zUrp-Astronomics/Cam87-Redux/#1_Logic_board/Cam87_Redux - Logic_board_v1.1 - 2_2D-view_bot.png

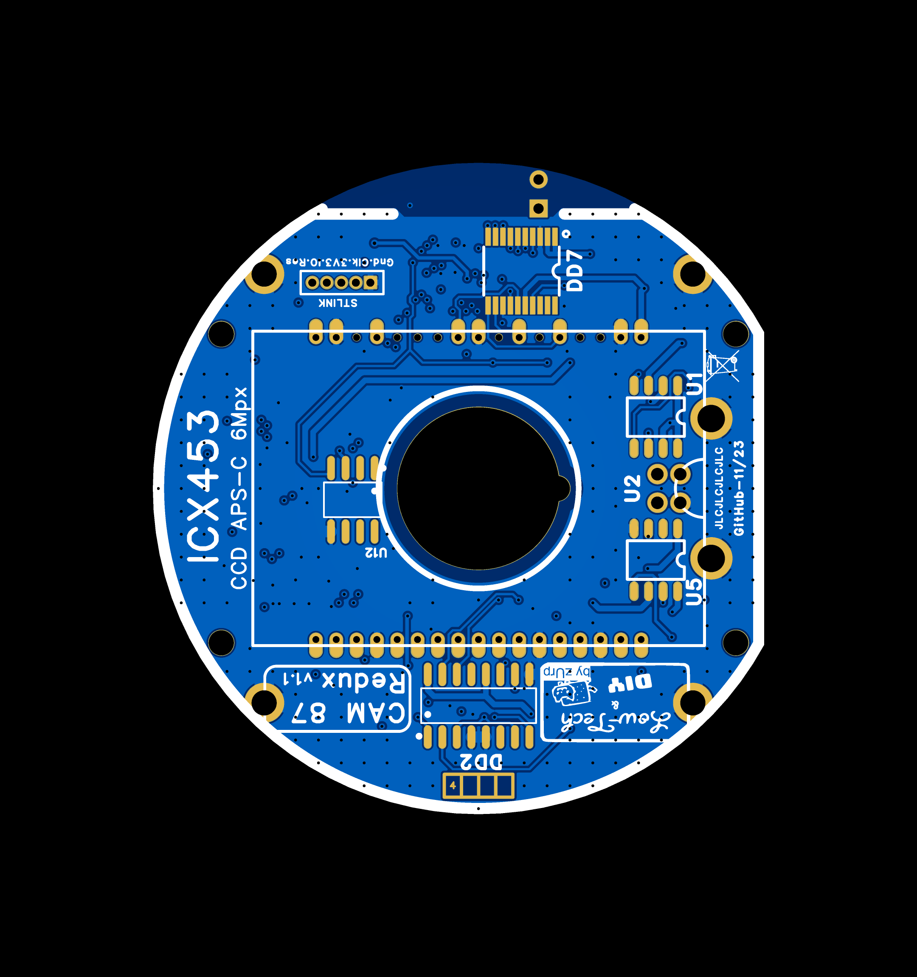
#1_Logic_board/Cam87_Redux - Logic_board_v1.1 - 2_2D-view_bot.png
