zUrp-Astronomics/Cam87-Redux/#2_Power_board/Cam87_Redux- Power_board_v1.1 - 2_2D-view_bot.png

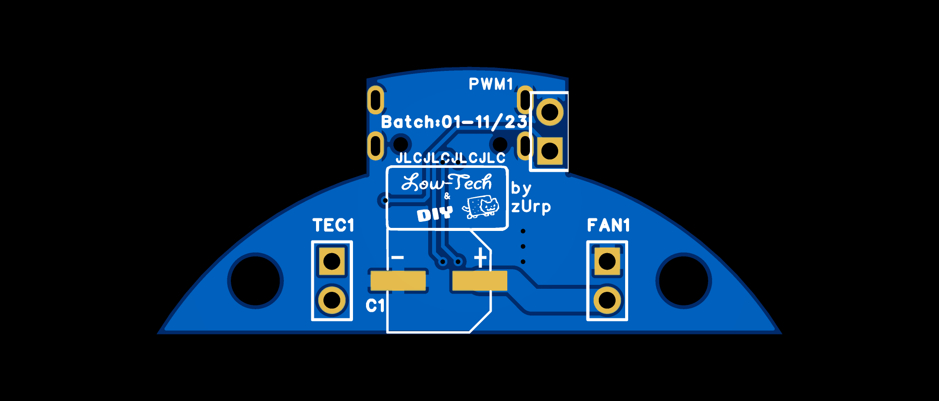
#2_Power_board/Cam87_Redux- Power_board_v1.1 - 2_2D-view_bot.png
