zUrp-Astronomics/Cam87-Redux/#2_Power_board/Cam87_Redux- Power_board_v1.1 - 4_BOM.xlsx

No. | Quantity | Device | Designator | Footprint | Value | Manufacturer Part | Manufacturer | Supplier Part | Supplier | Add into BOM | Name | Primary Category | Secondary Category | JLCPCB Stock | JLCPCB Price | JLCPCB Part Class
1 | 1 | 0603WAF0000T5E | 12V | R0603 | 0Ω | 0603WAF0000T5E | UNI-ROYAL(厚声) | C21189 | LCSC | yes | 0Ω | Resistors | Chip Resistor - Surface Mount | 9418308 | 0.00645 | Basic Part
2 | 1 | OVZ560M1ETR-0606 | C1 | CAP-SMD_BD6.3-L6.6-W6.6-FD-A | 56uF | OVZ560M1ETR-0606 | lelon(立隆) | C250116 | LCSC | yes | 56uF |  |  | 635 | 1.237 | ExtendedPart
3 | 1 | CL05A105KA5NQNC | C2 | C0402 | 1uF | CL05A105KA5NQNC | SAMSUNG(三星) | C52923 | LCSC | yes | 1uF |  |  | 2774039 | 0.0237 | BasicPart
4 | 3 | JST-XH-2P-M | FAN1,PWM1,TEC1 | HDR-M-2.54_1X2 |  | JST-XH-2P-M | JST | JST-XH-2P-M |  | yes | JST-XH-2P |  |  | 0
5 | 1 | AO3401A_C15127 | Q1 | SOT-23_L2.9-W1.3-P1.90-LS2.4-BR |  | AO3401A | AOS | C15127 | LCSC | yes | AO3401A | Triode/MOS Tube/Transistor | MOSFETs | 235251 | 0.394 | BasicPart
6 | 1 | AO3400A_C20917 | Q2 | SOT-23-3_L2.9-W1.6-P1.90-LS2.8-BR |  | AO3400A | AOS | C20917 | LCSC | yes | AO3400A | Triode/MOS Tube/Transistor | MOSFETs | 30849 | 0.488 | BasicPart
7 | 1 | 0402WGF1001TCE | R1 | R0402 | 1kΩ | 0402WGF1001TCE | UNI-ROYAL(厚声) | C11702 | LCSC | yes | 1kΩ | Resistors | Chip Resistor - Surface Mount | 5855534 | 0.0031 | BasicPart
8 | 1 | 0402WGF1002TCE | R2 | R0402 | 10k | 0402WGF1002TCE | UNI-ROYAL(厚声) | C25744 | LCSC | yes |  |  |  | 8885566 | 0.00292 | BasicPart
9 | 1 | CH224K | U1 | ESSOP-10_L4.9-W3.9-P1.0-LS6.0-TL-EP |  | CH224K | WCH(南京沁恒) | C970725 | LCSC | yes | CH224K | Communication Interface Chip/UART/485/232 | USB ICs | 3287 | 3.22 | ExtendedPart
10 | 1 | TYPE-C-31-E-01 | USB1 | TYPE-C-SMD_TYPE-C-31-E-01 |  | TYPE-C-31-E-01 | 韩国韩荣 | C530618 | LCSC | yes | TYPE-C-31-E-01 |  |  | 128 | 5.94 | ExtendedPart
