zUrp-Astronomics/Cam87-Redux/#1_Logic_board/Cam87_Redux - Logic_board_v1.1 - 4_BOM.xlsx

No. | Quantity | Device | Designator | Footprint | Value | Manufacturer Part | Manufacturer | Supplier Part | Supplier | Add into BOM | Name | Primary Category | Secondary Category | JLCPCB Stock | JLCPCB Price | JLCPCB Part Class
1 | 20 | CL05B104KB54PNC | C1,C3,C8,C11,C12,C13,C15,C22,C27,C28,C29,C30,C33,C34,C80,C83,C84,C85,C100,C101 | C0402 | 100nF | CL05B104KB54PNC | SAMSUNG(三星) | C307331 | LCSC | yes | 100nF | Capacitors | Multilayer Ceramic Capacitors MLCC - SMD/SMT | 3210689 | 0.0428 | Basic Part
2 | 13 | CL05A105KA5NQNC | C2,C4,C6,C9,C25,C36,C37,C74,C75,C82,C86,C87,C89 | C0402 | 1uF | CL05A105KA5NQNC | SAMSUNG(三星) | C52923 | LCSC | yes | 1uF |  |  | 2776105 | 0.0237 | Basic Part
3 | 1 | CL05C100JB5NNNC | C5 | C0402 | 10pF | CL05C100JB5NNNC | SAMSUNG(三星) | C32949 | LCSC | yes | 10pF |  |  | 187520 | 0.0343 | Basic Part
4 | 1 | TAJD476K025RNJ | C7 | CAP-SMD_L7.3-W4.3-R-RD |  | TAJD476K025RNJ | AVX | C7228 | LCSC | yes | 47uF |  |  | 9636 | 3.8 | Extend
5 | 3 | CC0603KRX7R9BB104 | C10,C26,C31 | C0603 | 100nF | CC0603KRX7R9BB104 | YAGEO(国巨) | C14663 | LCSC | yes | 100nF |  |  | 26465158 | 0.0142 | Basic Part
6 | 3 | CL10A106KP8NNNC | C16,C17,C98 | C0603 | 10uF | CL10A106KP8NNNC | SAMSUNG(三星) | C19702 | LCSC | yes | 10uF |  |  | 2289457 | 0.0338 | Basic Part
7 | 2 | CL31A107MQHNNNE | C18,C79 | C1206 | 100uF | CL31A107MQHNNNE | SAMSUNG(三星) | C15008 | LCSC | yes | 100uF |  |  | 97979 | 0.398 | Basic Part
8 | 2 | 0402CG8R2C500NT | C23,C24 | C0402 | 8.2pF | 0402CG8R2C500NT | FH(风华) | C1579 | LCSC | yes | 8.2pF |  |  | 18688 | 0.0064 | Extended Part
9 | 2 | 0603B201K500NT | C71,C72 | C0603 |  | 0603B201K500NT | FH | C1600 | LCSC | yes | 200pF |  |  | 46770 | 0.0227 | Basic
10 | 2 | TCN4227M025R0100 | C73,C97 | CAP-SMD_L7.3-W6.1_TCN4227M025R0100 | 220uF | TCN4227M025R0100 | Kyocera AVX | C2158994 | LCSC | yes | 220uF | Capacitors | Tantalum Capacitors | 763 | 18.69 | Extended Part
11 | 3 | TAJC227K010RNJ | C77,C95,C96 | CAP-SMD_L6.0-W3.2-R-RD | 220uF | TAJC227K010RNJ | Kyocera AVX | C8023 | LCSC | yes | 220uF |  |  | 564 | 3.22 | Extended Part
12 | 1 | CL05A106MQ5NUNC | C78 | C0402 | 10uF | CL05A106MQ5NUNC | SAMSUNG(三星) | C15525 | LCSC | yes | 10uF |  |  | 7094435 | 0.029 | Basic Part
13 | 1 | 47uF 10V | C88 | C1206 |  | CL31A476MPHNNNE | SAMSUNG | C96123 | LCSC | yes | 47uF 10V |  |  | 311116 | 0.466 | Basic
14 | 1 | CL10B102KB8NNNC | C99 | C0603 | 1nF | CL10B102KB8NNNC | SAMSUNG(三星) | C1588 | LCSC | yes | 1nF |  |  | 5179975 | 0.0169 | Basic Part
15 | 1 | AD9826KRSZ | DD1 | SSOP-28_L10.2-W5.3-P0.65-LS7.8-BL |  | AD9826KRSZ | ADI | C13734 | LCSC | yes | AD9826KRSZ |  |  | 1754 | 38.09 | Extend
16 | 1 | EL7457CSZ | DD2 | SOIC-16_L9.9-W3.9-P1.27-LS6.0-BL |  | EL7457CSZ | RENESAS(瑞萨)/IDT | C3655423 | LCSC | yes | EL7457CSZ |  |  | 0 | 49.68
17 | 1 | STM32F103C8T6 | DD3 | LQFP-48_L7.0-W7.0-P0.50-LS9.0-BL |  | STM32F103C8T6 | STMicroelectronics | C8734 | LCSC | yes | STM32F103C8T6 |  |  | 56433 | 8.93 | Basic
18 | 1 | FT2232HL-REEL | DD5 | LQFP-64_L10.0-W10.0-P0.50-LS12.0-TL |  | FT2232HL-REEL | FTDI(飞特帝亚) | C27882 | LCSC | yes | FT2232HL-REEL |  |  | 59 | 36.83 | Extended Part
19 | 1 | CXD1267AN | DD7 | TSSOP-20_L6.5-W4.4-P0.65-LS6.4-BL |  | Sony |  |  |  | yes | CXD1267AN
20 | 1 | CBC2012T220K | L1 | L0805 | 22uH | CBC2012T220K | TAIYO YUDEN(太诱) | C223184 | LCSC | yes | 22uH |  |  | 7 | 0.786 | Extended Part
21 | 2 | CBC3225T221KR | L7,L8 | L1210 | 220uH | CBC3225T221KR | TAIYO YUDEN(太诱) | C223231 | LCSC | yes | 220uH | Inductors/Coils/Transformers | Power Inductors | 262 | 0.642 | Extended Part
22 | 1 | 12MHz | Q2 | OSC-SMD_4P-L3.2-W2.5-BL |  | X322512MSB4SI | YXC | C9002 | LCSC | yes | 12MHz |  |  | 201387 | 0.372 | Basic
23 | 3 | 0603WAF301KT5E | R1,R2,R10 | R0603 | 3.01Ω | 0603WAF301KT5E | UNI-ROYAL(厚声) | C270936 | LCSC | yes | 3.01Ω |  |  | 28 | 0.0124 | Extended Part
24 | 1 | AC0402FR-07750RL | R3 | R0402 | 750Ω | AC0402FR-07750RL | YAGEO(国巨) | C227221 | LCSC | yes | 750Ω |  |  | 7573 | 0.0066 | Extended Part
25 | 1 | 0402WGF1000TCE | R4 | R0402 | 100Ω | 0402WGF1000TCE | UNI-ROYAL(厚声) | C25076 | LCSC | yes | 100Ω |  |  | 2005191 | 0.00292 | Basic Part
26 | 1 | 0402WGF5100TCE | R5 | R0402 | 510Ω | 0402WGF5100TCE | UNI-ROYAL(厚声) | C25123 | LCSC | yes | 510Ω |  |  | 386746 | 0.00303 | Basic Part
27 | 2 | 0402WGF1003TCE | R6,R11 | R0402 | 100kΩ | 0402WGF1003TCE | UNI-ROYAL(厚声) | C25741 | LCSC | yes | 100kΩ |  |  | 3170292 | 0.00301 | Basic Part
28 | 1 | 0402WGF1004TCE | R7 | R0402 | 1MΩ | 0402WGF1004TCE | UNI-ROYAL(厚声) | C26083 | LCSC | yes | 1MΩ |  |  | 1271919 | 0.00322 | Basic Part
29 | 1 | 0402WGF220JTCE | R8 | R0402 | 22Ω | 0402WGF220JTCE | UNI-ROYAL(厚声) | C25092 | LCSC | yes | 22Ω |  |  | 1354420 | 0.00305 | Basic Part
30 | 1 | 0603WAF2402T5E | R9 | R0603 |  | 0603WAF2402T5E | UniOhm | C23352 | LCSC | yes | 24K |  |  | 554806 | 0.00625 | Basic
31 | 2 | CRCW0402180RFKED | R12,R25 | R0402 | 180Ω | CRCW0402180RFKED | VISHAY(威世) | C481962 | LCSC | yes | 180Ω |  |  | 2673 | 0.04 | Extended Part
32 | 4 | 0402WGF1002TCE | R14,R15,R28,R32 | R0402 | 10kΩ | 0402WGF1002TCE | UNI-ROYAL(厚声) | C25744 | LCSC | yes | 10kΩ |  |  | 8896301 | 0.00292 | Basic Part
33 | 2 | HP03W5F500LT5E | R20,R24 | R0603 | 500mΩ | HP03W5F500LT5E | UNI-ROYAL(厚声) | C414986 | LCSC | yes | 500mΩ |  |  | 2025 | 0.202 | Extended Part
34 | 1 | 0603WAF1302T5E | R22 | R0603 |  | 0603WAF1302T5E | UniOhm | C22797 | LCSC | yes | 13K |  |  | 313642 | 0.00617 | Basic
35 | 1 | 0603WAF2401T5E | R23 | R0603 |  | 0603WAF2401T5E | UniOhm | C22940 | LCSC | yes | 2.4K |  |  | 306378 | 0.00609 | Basic
36 | 1 | 0402WGF2202TCE | R26 | R0402 | 22kΩ | 0402WGF2202TCE | UNI-ROYAL(厚声) | C25768 | LCSC | yes | 22kΩ |  |  | 530038 | 0.00306 | Basic Part
37 | 1 | 0402WGF2001TCE | R27 | R0402 | 2kΩ | 0402WGF2001TCE | UNI-ROYAL(厚声) | C4109 | LCSC | yes | 2kΩ |  |  | 2420582 | 0.00303 | Basic Part
38 | 1 | 0402WGF2201TCE | R29 | R0402 | 2.2kΩ | 0402WGF2201TCE | UNI-ROYAL(厚声) | C25879 | LCSC | yes | 2.2kΩ |  |  | 795002 | 0.0031 | Basic Part
39 | 1 | 0402WGF1001TCE | R30 | R0402 | 1kΩ | 0402WGF1001TCE | UNI-ROYAL(厚声) | C11702 | LCSC | yes | 1kΩ |  |  | 5857364 | 0.0031 | Basic Part
40 | 1 | 0402WGF1202TCE | R31 | R0402 | 12kΩ | 0402WGF1202TCE | UNI-ROYAL(厚声) | C25752 | LCSC | yes | 12kΩ |  |  | 459663 | 0.00311 | Basic Part
41 | 1 | 0402WGF5101TCE | R33 | R0402 | 5.1kΩ | 0402WGF5101TCE | UNI-ROYAL(厚声) | C25905 | LCSC | yes | 5.1kΩ |  |  | 1149428 | 0.00315 | Basic Part
42 | 2 | MC34063ADR2G | U1,U5 | SOIC-8_L5.0-W4.0-P1.27-LS6.0-BL |  | MC34063ADR2G | ON | C32078 | LCSC | yes | MC34063ADR2G |  |  | 18536 | 3.57 | Basic
43 | 1 | Sony | U2 | ICX453AQ |  | Sony |  |  |  | yes | ICX453AQ
44 | 1 | AMS1117-3.3 | U3 | SOT-223-3_L6.5-W3.4-P2.30-LS7.0-BR |  | AMS1117-3.3 | AMS | C6186 | LCSC | yes | AMS1117-3.3 |  |  | 383760 | 0.887 | Basic
45 | 1 | 78N06G-AB3-R | U4 | SOT-89-3_L4.5-W2.5-P1.50-LS4.2-BR |  | 78N06G-AB3-R | UTC | C84863 | LCSC | yes | 78N06G-AB3-R |  |  | 8726 | 0.359 | Extend
46 | 1 | FT93C46A-USR-T | U8 | SOP-8_L4.9-W3.9-P1.27-LS6.0-BL |  | FT93C46A-USR-T | FMD(辉芒微) | C2902369 | LCSC | yes | FT93C46A-USR-T | Memory | EEPROM | 150 | 0.692 | Extended Part
47 | 1 | APV1111GV1Y | U11 | SSOP-4_L4.5-W2.6-P1.27-LS4.8-TL |  | APV1111GV1Y | PANASONIC(松下) | C2977173 | LCSC | yes | APV1111GV1Y | Optocoupler/LED/Digital Tube/Photoelectric Device | Optocouplers - Logic Output | 301 | 21.94 | Extended Part
48 | 1 | DS18B20Z+T&R | U12 | SOIC-8_L4.9-W3.9-P1.27-LS6.0-BL |  | DS18B20Z+T&R | ADI(亚德诺)/MAXIM(美信) | C97190 | LCSC | yes | DS18B20Z+T&R | Sensors | Temperature Sensors | 2322 | 9.39 | Extended Part
49 | 1 | MBR0530T1G | VD2 | SOD-123_L2.8-W1.8-LS3.7-RD |  | MBR0530T1G | ON | C82046 | LCSC | yes | MBR0530 |  |  | 39033 | 0.654 | Extend
50 | 2 | SS34 | VD3,VD4 | DO-214AC_L4.3-W2.7-LS5.3-RD |  | SS34 | MDD | C8678 | LCSC | yes | SS34_C8678 |  |  | 964662 | 0.145 | Basic
51 | 1 | IRLML6302TRPBF | VT1 | SOT-23-3_L2.9-W1.6-P1.90-LS2.8-BR |  | IRLML6302TRPBF | IR | C24097 | LCSC | yes | IRLML6302 |  |  | 29721 | 0.831 | Extend
52 | 1 | IRLML2803TRPBF | VT2 | SOT-23-3_L2.9-W1.3-P1.90-LS2.4-BR |  | IRLML2803TRPBF | Infineon | C2590 | LCSC | yes | IRLML2803 |  |  | 0 | 0.733 | Extend
