zUrp-Astronomics/Cam87-Redux/#3_Hardware/Cam87_Redux - Cold_plate - bot_core.step

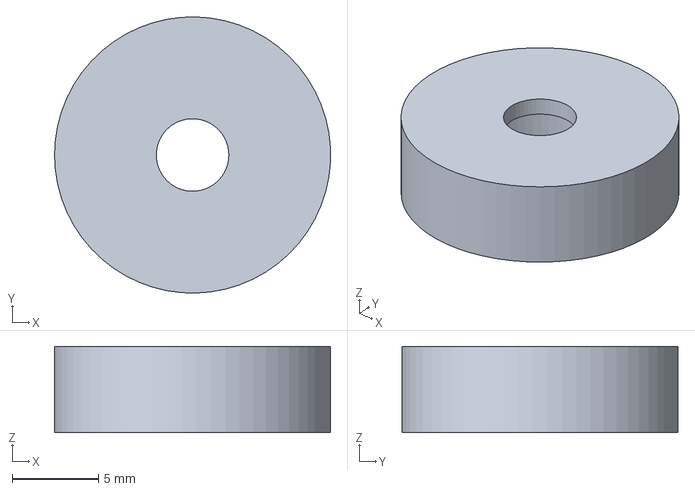
[picture p9: CAD file, 2023-11-28]
#3_Hardware/Cam87_Redux - Cold_plate - bot_core.step
16.0 x 16.0 x 5.00 mm
