zUrp-Astronomics/Cam87-Redux/#8_3D_Models/Cam87_Redux.step

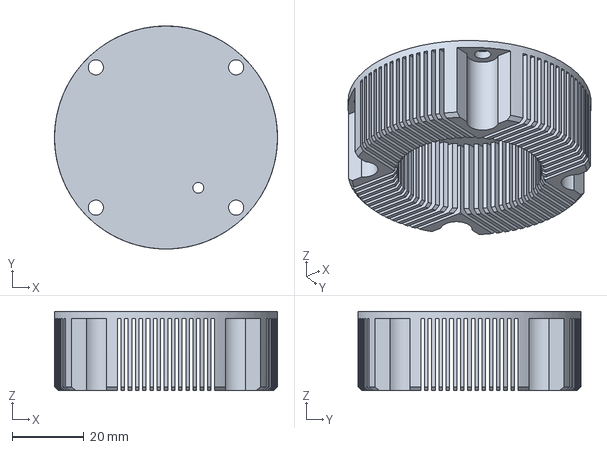
[picture p10: CAD file, 2023-11-28]
#8_3D_Models/Cam87_Redux.step
62.0 x 62.0 x 22.0 mm
