zUrp-Astronomics/Cam87-Redux/#3_Hardware/Cam87_Redux - Cold_plate - bot_plate.step

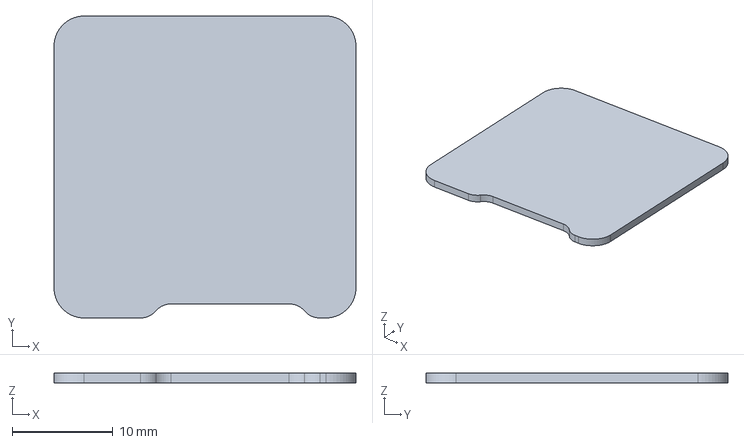
[picture p11: CAD file, 2023-11-28]
#3_Hardware/Cam87_Redux - Cold_plate - bot_plate.step
30.0 x 30.0 x 1.00 mm
