zUrp-Astronomics/Cam87-Redux/#3_Hardware/Cam87_Redux - Cold_plate - top.step

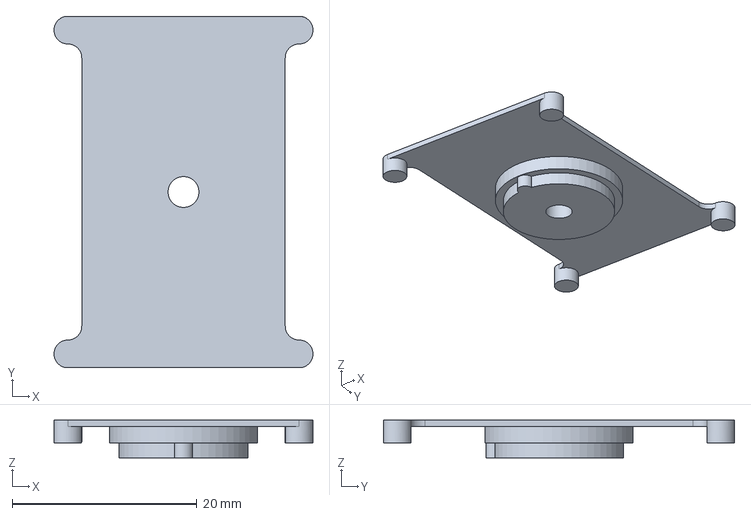
[picture p12: CAD file, 2023-11-28]
#3_Hardware/Cam87_Redux - Cold_plate - top.step
28.0 x 38.0 x 4.10 mm
