zUrp-Astronomics/Cam87-Redux/(list of files, cad)

Other CAD files:
#3_Hardware/Cam87_Redux - Heatsink.step
