zUrp-Astronomics/Cam87-Redux/#2_Power_board/Cam87_Redux- Power_board_v1.1 - 1_schematic.pdf

# USB-C PD - 12V / 1.5A

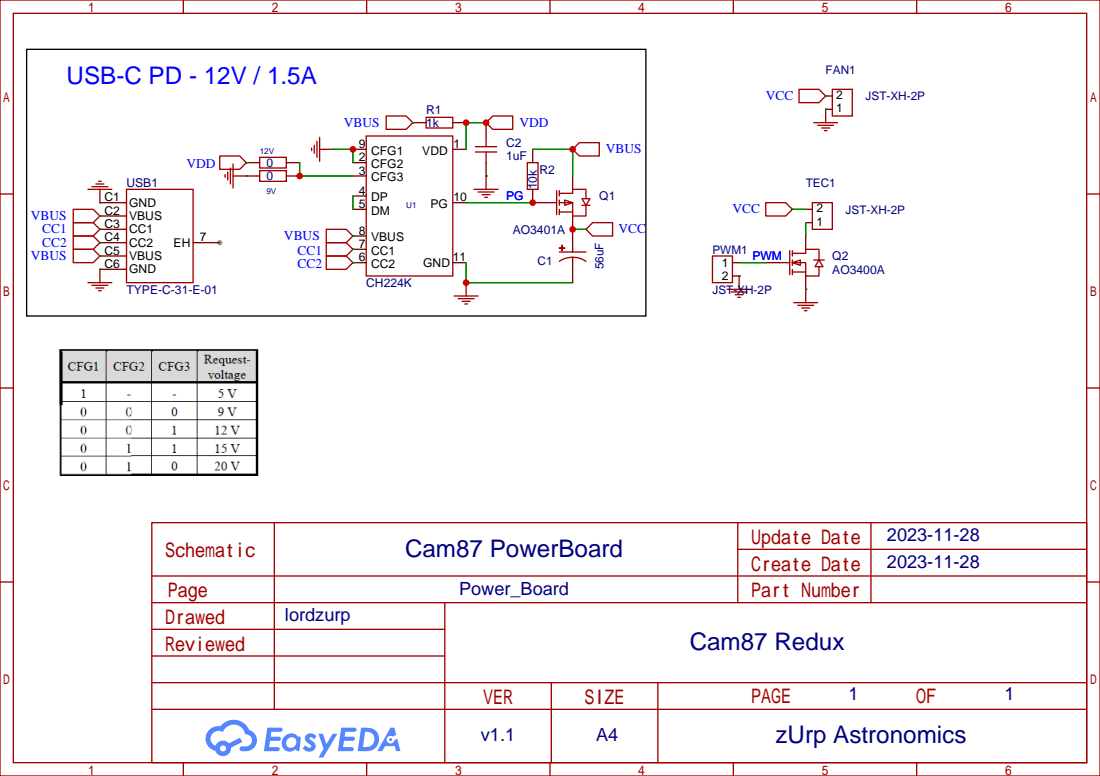
[picture p14: page 1]
