zUrp-Astronomics/Cam87-Redux/#1_Logic_board/Cam87R_edux - Logic_board_v1.1 - 1_schematics.pdf

### #1 USB

#4 3V3

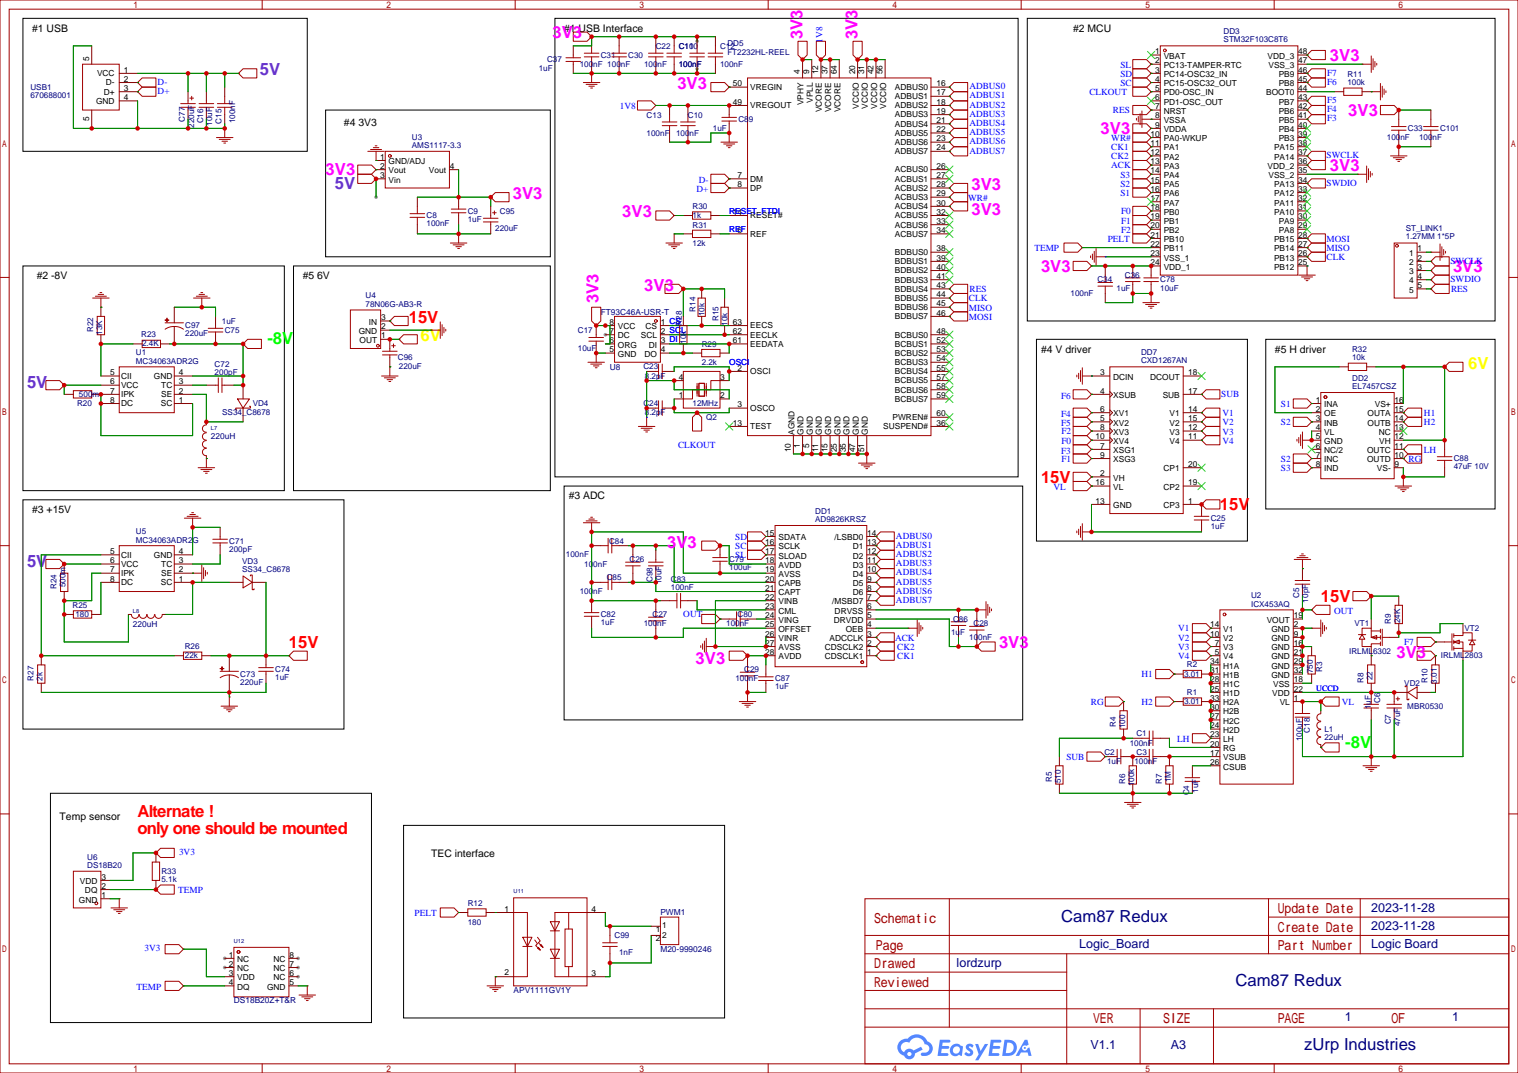
[picture p15: page 1]

only one should be mounted
