zUrp-Astronomics/Cam87-Redux/#3_Hardware/Cam87_Redux - Cold_plate - top.pdf

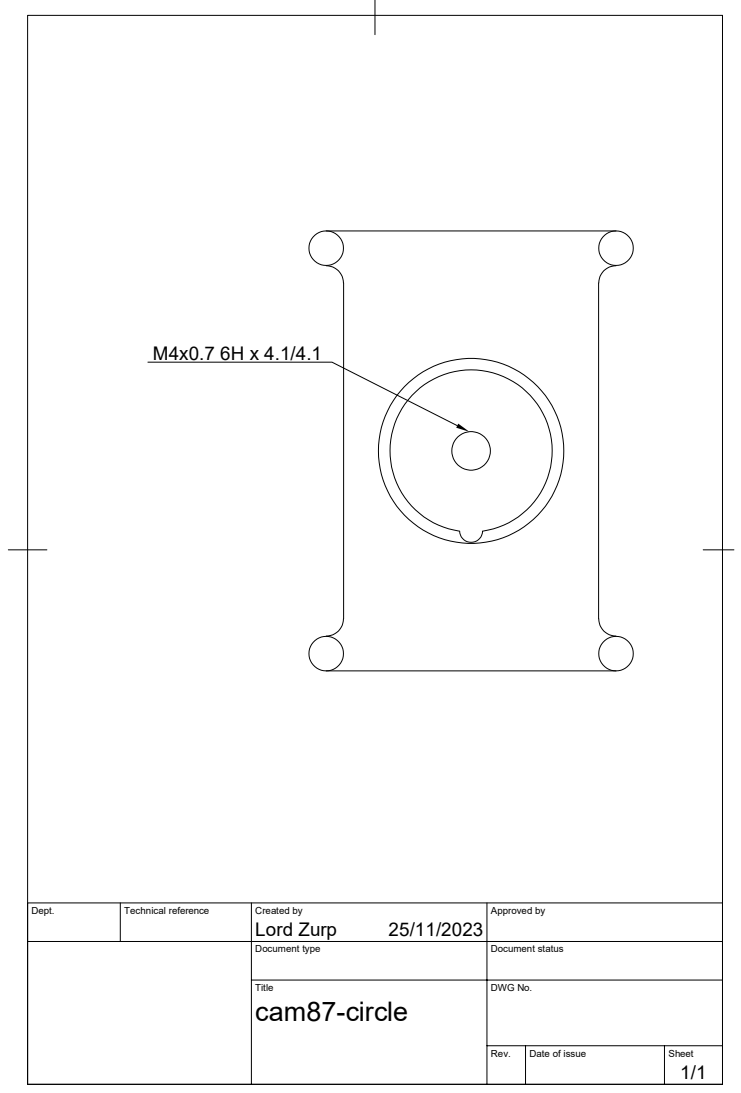
[picture p16: page 1]
Dept.; Technical reference; Created by; Approved by; Document type; Document status; Title; DWG No.; Rev.; Date of issue; Sheet; cam87-circle; Lord Zurp
