zUrp-Astronomics/Cam87-Redux/(commit log)

2023-11-28 add datasheet + random stuff
    [Cam87R_edux - Logic_board_v1.1 - 4_BOM.xlsx, Cam87R_edux - Logic_board_v1.1 - 5_PnP.xlsx, Cam87_Redux - Cold_plate - bot_core.step, Cam87_Redux - Cold_plate - bot_plate.step, Cam87_Redux - Cold_plate - heatsink.step, Cam87_Redux - Cold_plate - top.step, Cam87_Redux- Power_board_v1.1 - 4_BOM.xlsx, Cam87_Redux- Power_board_v1.1 - 5_PnP.xlsx]
2023-11-29 add indi driver repo
